bogdan-mitrea/voltage-regulator_p1/Layout/layout.JPG

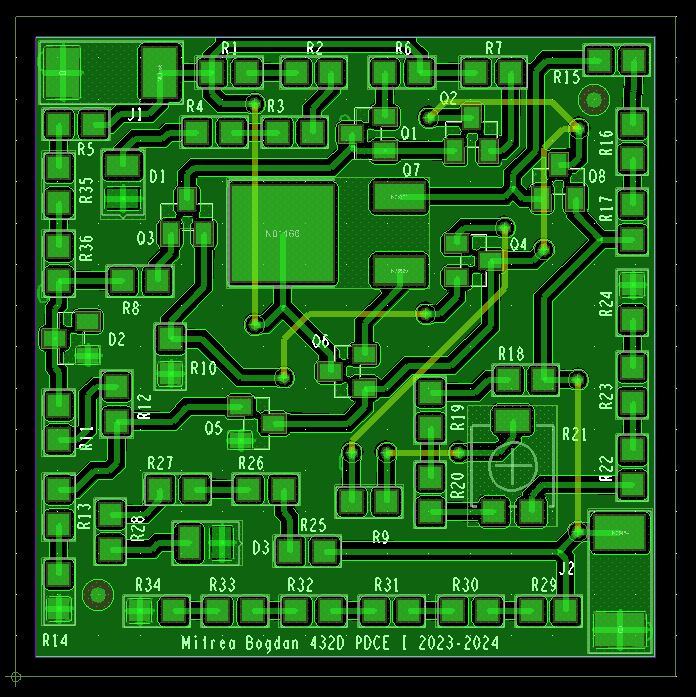
Layout/layout.JPG
