bogdan-mitrea/voltage-regulator_p1/Proiect docs/P1 documentatie.pdf

# Universitatea „POLITEHNICA” Bucuresti

FACULTATEA DE ELECTRONICĂ, TELECOMUNICAȚII ȘI TEHNOLOGIA INFORMAȚIEI

# Proiect 1

# Stabilizator de tensiune cu Element de Reglaj Serie (ERS)

# Mitrea Bogdan-Gabriel

# Grupa 432Da

2023 – 2024

## Tema 3 - Stabilizator de tensiune cu Element de Reglaj Serie (ERS)

### 1. Tema proiectului:

Se proiecteaza si se realizeaza un stabilizator de tensiune cu ERS avand urmatoarele caracteristici:

¨ Tensiunea de ieșire reglabilă în intervalul: 9,5 ÷ 19 [V];

¨ Element de reglaj serie;

¨ Sarcina la ieșire: 760 [Ω];

¨ Deriva termică < 2mV/oC;

¨ Protecție la suprasarcină prin limitarea temperaturii tranzistorului regulator serie la 120oC, si a curentului maxim la 0,5A;

¨ Tensiune de intrare în intervalul: 34,2 ÷ 38 [V];

¨ Amplificarea în tensiune minimă (în buclă deschisă) a amplificatorului de eroare: minim 100;

¨ Domeniul temperaturilor de funcționare: 0o

-60o C (verificabil prin testare în temperatură);

¨ Semnalizarea prezenței tensiunilor de intrare/ieșire cu diodă de tip LED.

### 2. Schema bloc functionala:

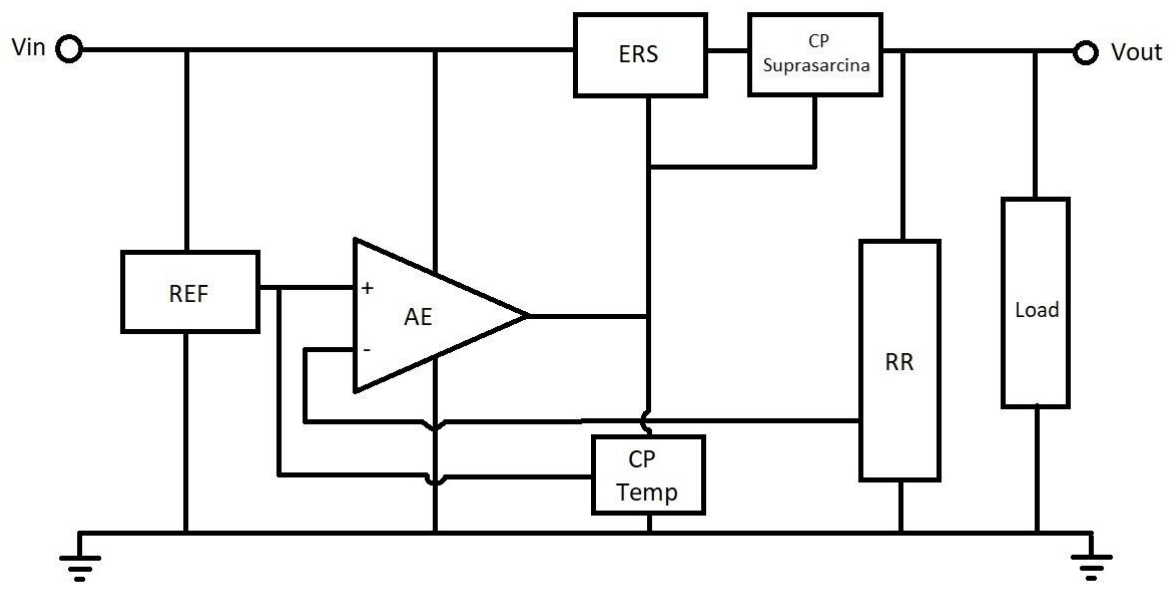
[picture p8: figure]

Se folosește un sistem de stabilizare cu un element regulator în serie (ERS) controlat de un amplificator de eroare (AE), care compară tensiunea furnizată de referință (REF) cu tensiunea preluată de la ieșire prin intermediul rețelei de reacție (RR). De asemenea, este implementat un circuit de protecție împotriva suprasarcinii, si împotriva temperaturii.

### 3. Schema electrica detaliata:

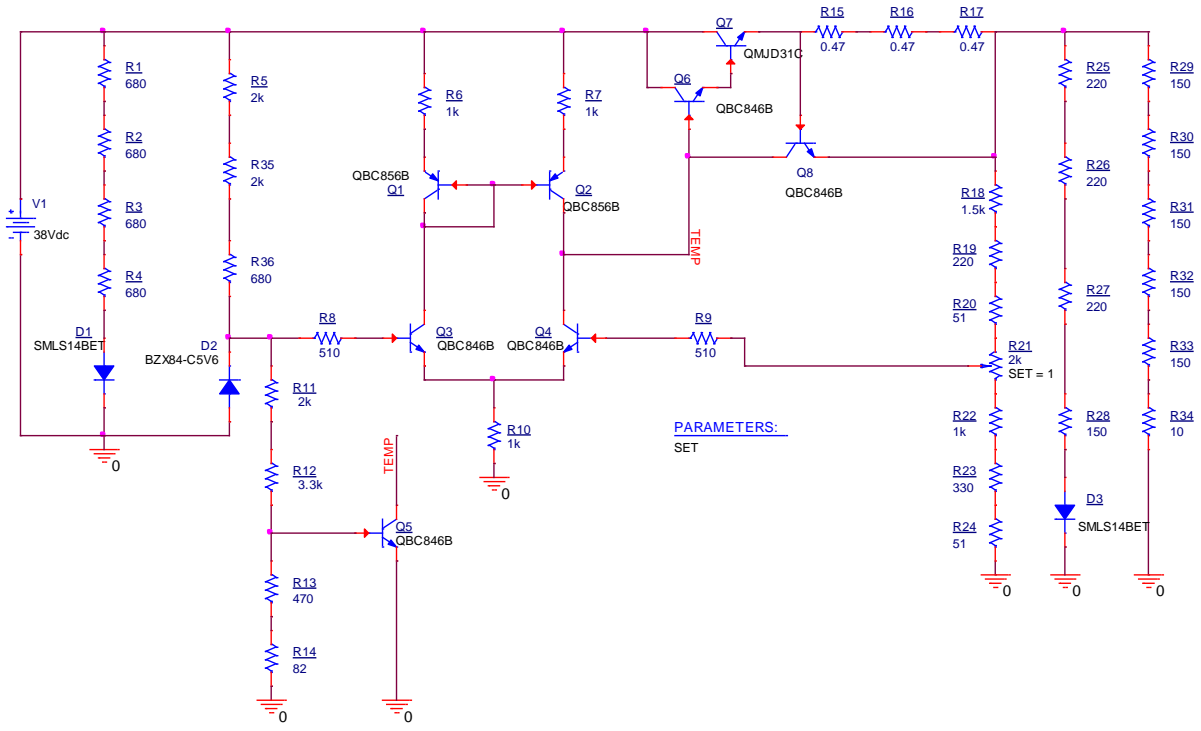
[picture p9: figure]
QBC846B; PARAMETERS:; SET; SMLS14BET; R21 2k SET = 1; Q3 QBC846B; 38Vdc; QMJD31C; Q5 QBC846B; Q4 QBC846B; Q2 QBC856B; QBC856BTEMP; D1 SMLS14BET; TEMP; 510 D2 BZX84-C5V6

Referinta de tensiune: R5, R35, R36, D2; D2 are o tensiune constanta, iar R5, R35 si R36 regleaza curentul care ajunge catre D2 si catre circuitul de protectie la temperatura.

Amplificatorul de eroare: Q1 - Q4, R6 – R10; Oglinda de curent are rolul de a diviza curentul in 2 curenti egali, iar rezistenta R10 pentru a putea cadea pe acea rezistenta o tensiune. R8 si R9 ajuta la amplificare – cu ajutorul lor am putut seta o amplificare dorita (3000).

Circuitul de protectie la temperatura: Q5, R11 – R14; Alegerea raportului de rezistente este important pentru a seta VBE la o valoare sub 0.7V (in acest caz 0.53V), din care se poate afla Ic al tranzistorului, care va trebui sa se deschida, sa curga curent prin el la o temperatura de 120⁰C.

Circuitul de protectie la suprasarcina: Q8, R15 – R17; Trebuie aleasa o rezistenta cat mai mica, deoarece la scurtcircuit la iesire, toata tensiunea va cadea pe rezistenta mica => curent mare, dimensionat la aproximativ 0.5A.

Elementul de reglaj serie: Q6, Q7; Stabilizeaza tensiunea de iesire.

Reteaua de reactie negativa: R18 – R24; Pentru a regla tensiunea minima, respectiv maxima la iesire, prin prezenta unui potentiometru.

Load: R29 – R34; Pentru stabilitate, si pentru a regla cantitatea de curent care trece prin circuit.

Relatii de dimensionare:

Vout / Vref = 1 + (R18 + R19 + R20 + SET*R21) / ((1-SET)*R21 + R22 + R23 + R24);

Vref reprezinta tensiunea de la intrarea amplificatorului de eroare.

De asemenea, un rol important la protectia asupra sarcinii si a temperaturii o au dimensionarea divizorului de
tensiune R11-12 | R13-14 si alegerea rezistentei foarte mici.

In circuit exista si doua ramuri pe care apar doua LED-uri, pentru a semnaliza tensiunea de intrare, respectiv iesire. Alegerea rezistentelor conectate in serie cu cele doua LED-uri depind de reglarea intensitatii care trece prin LED: ILED intre [10,20] mA.

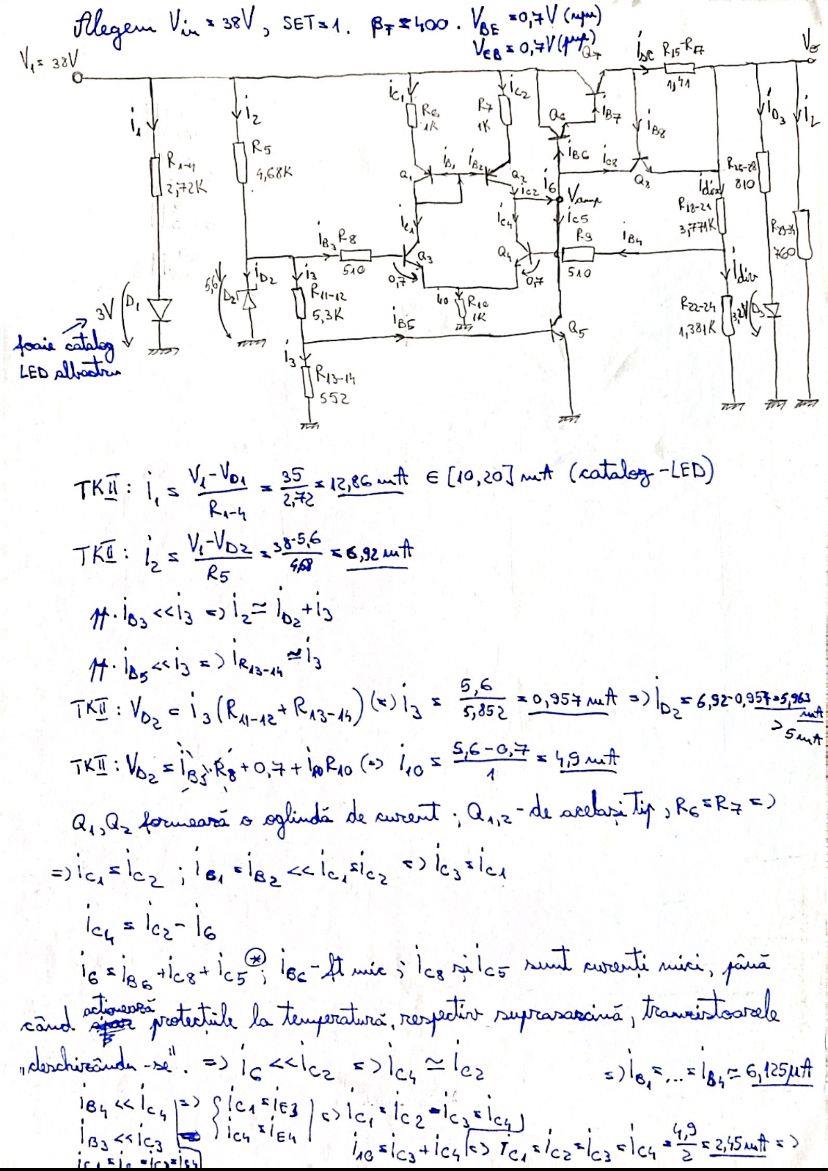
[picture p10: page 5]

Punctul static de functionare(PSF) calculat (pentru SET = 1):

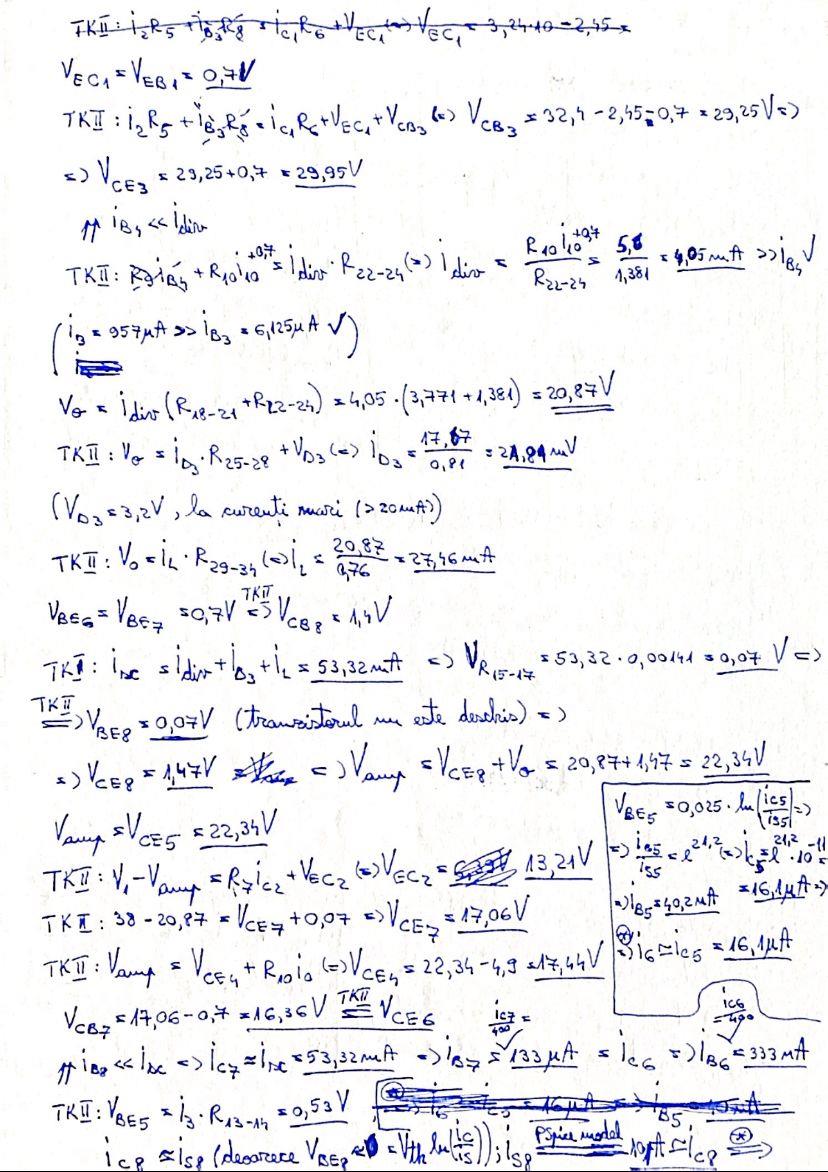
[picture p11: page 6]
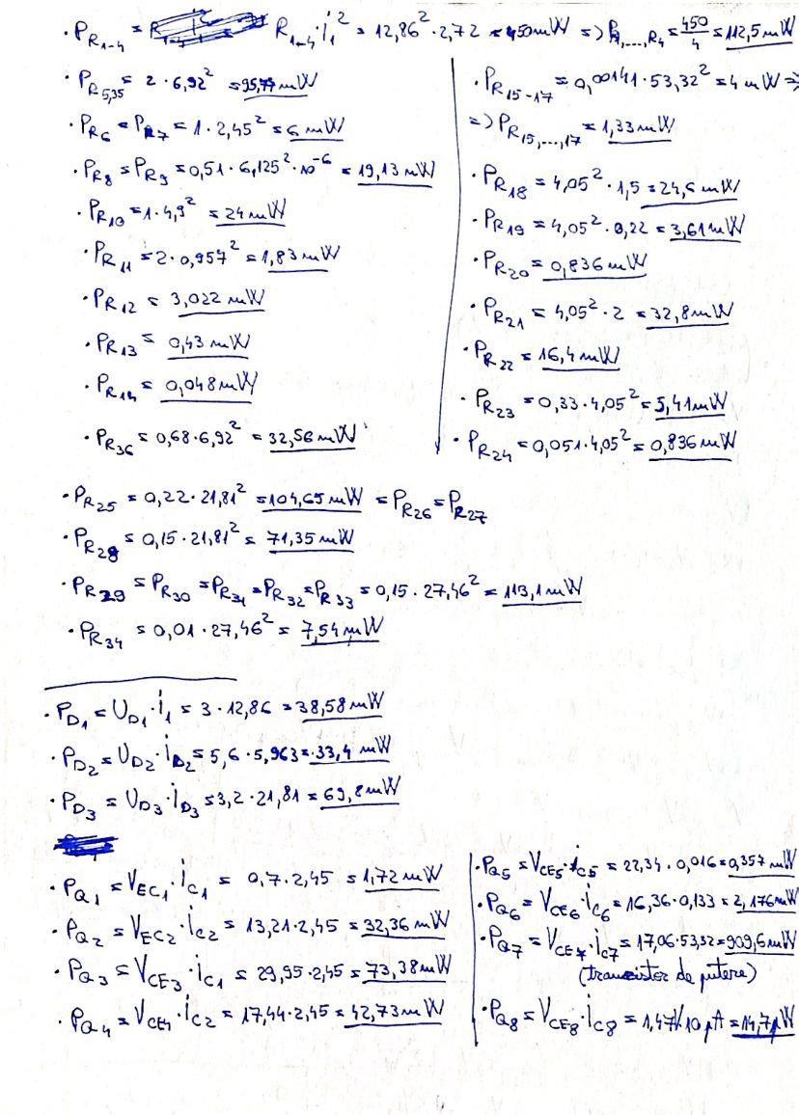
[picture p12: page 7]
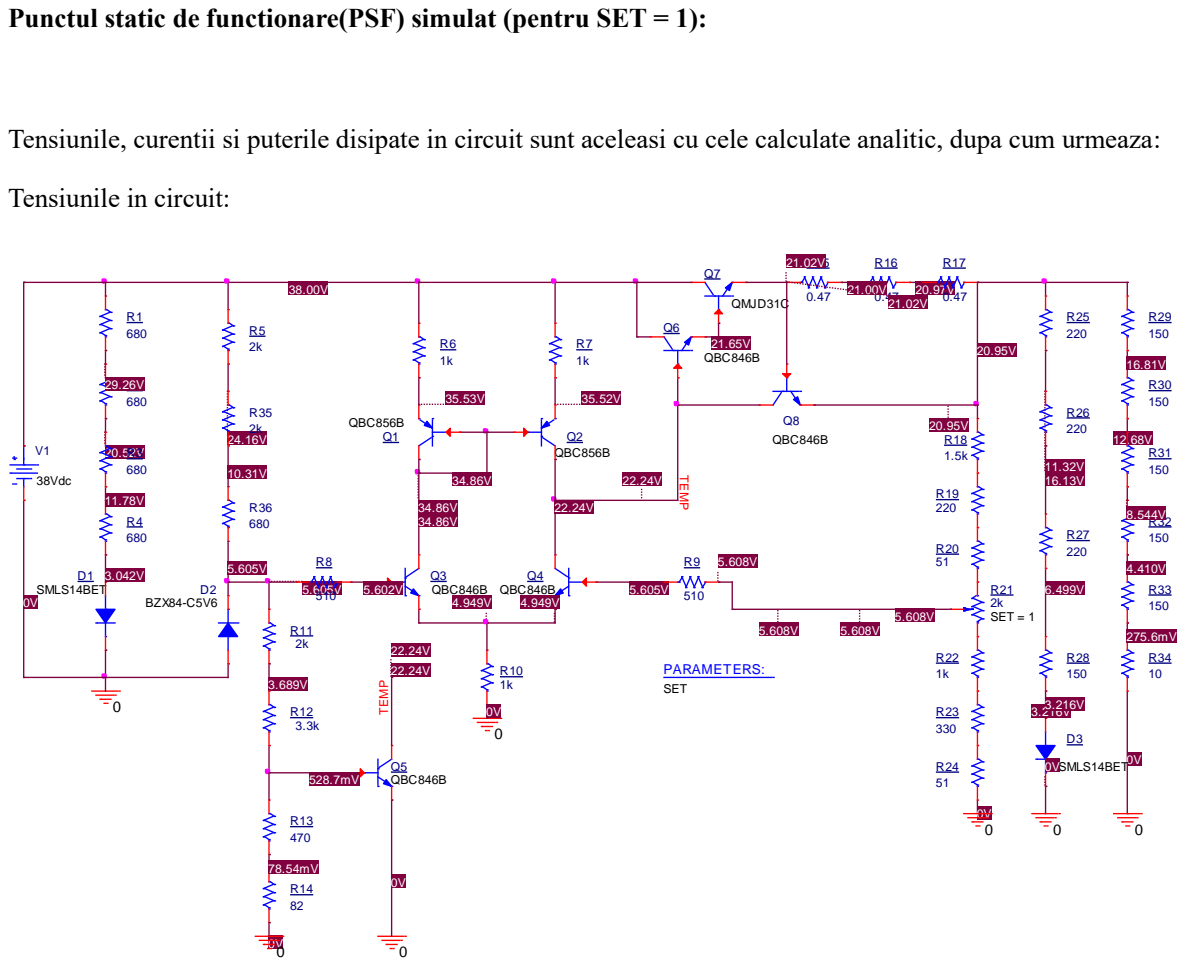
[picture p13: page 8]

Punctul static de functionare(PSF) simulat (pentru SET = 1):

Tensiunile, curentii si puterile disipate in circuit sunt aceleasi cu cele calculate analitic, dupa cum urmeaza:

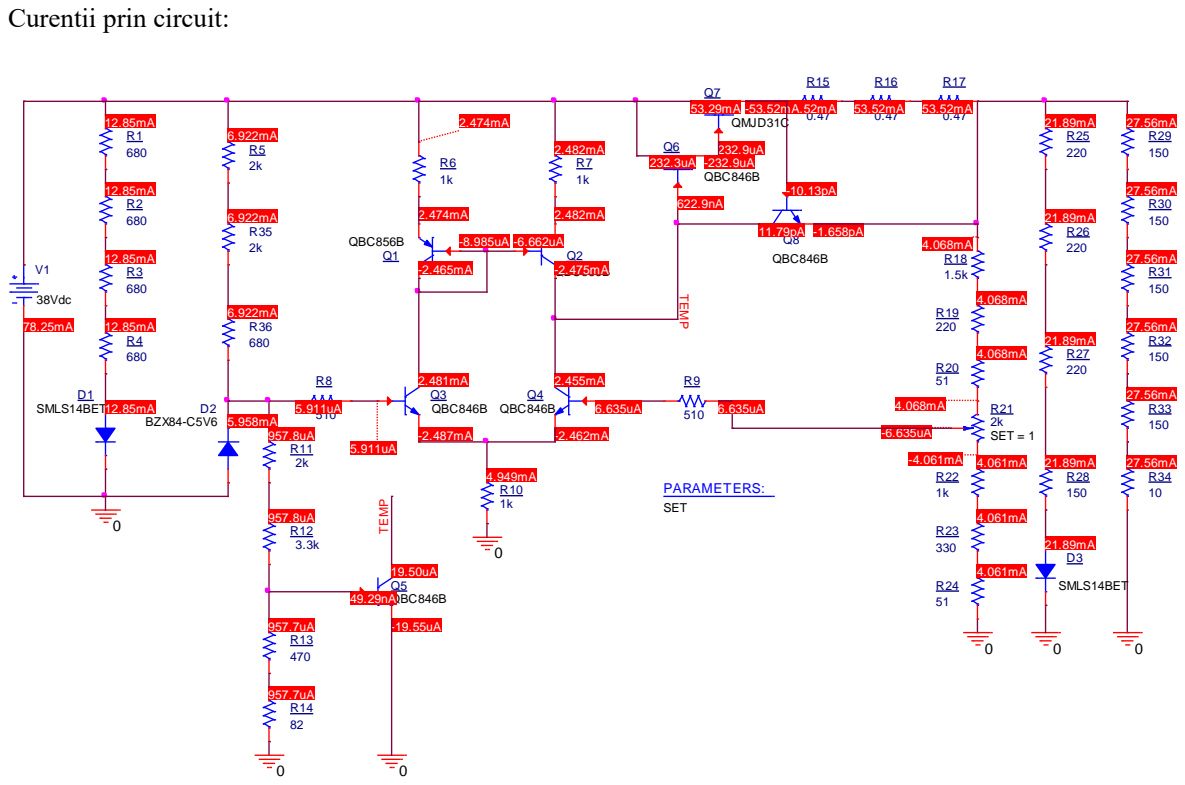
[picture p14: page 9]

# QBC856B 1.640mW TEMP

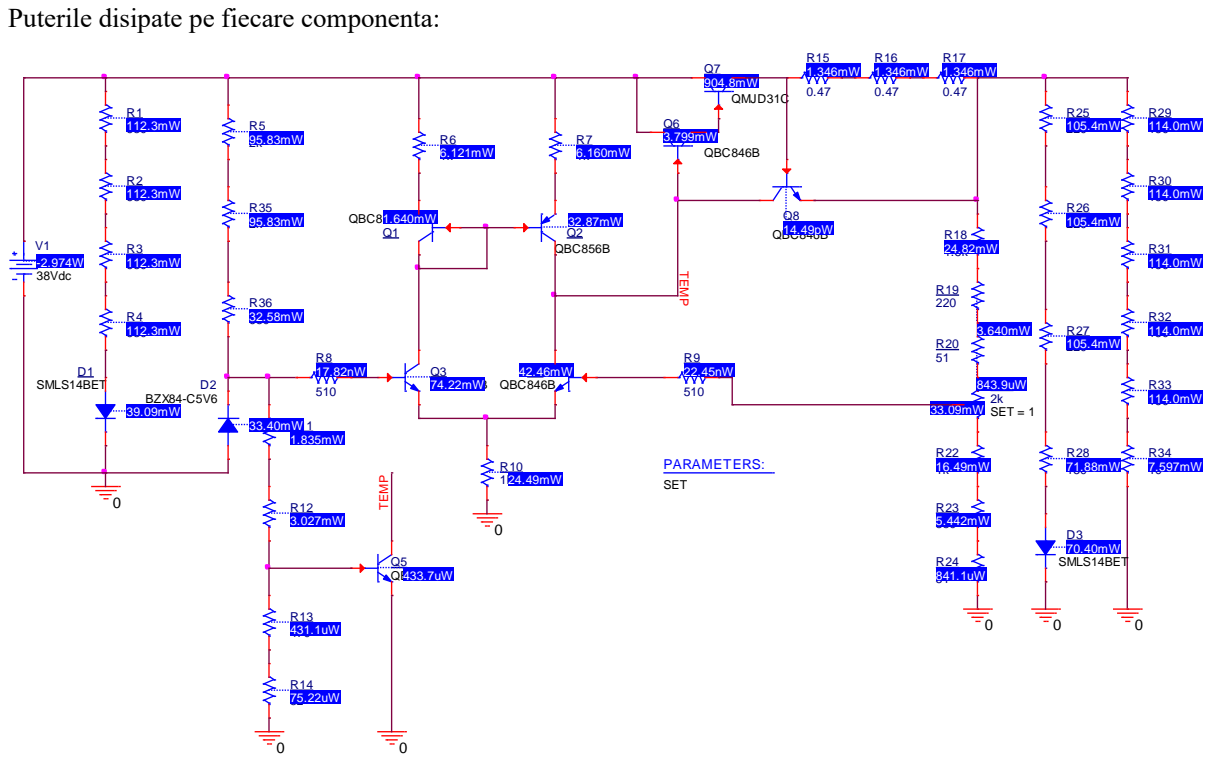
[picture p15: page 10]

Puterile disipate pe fiecare componenta:

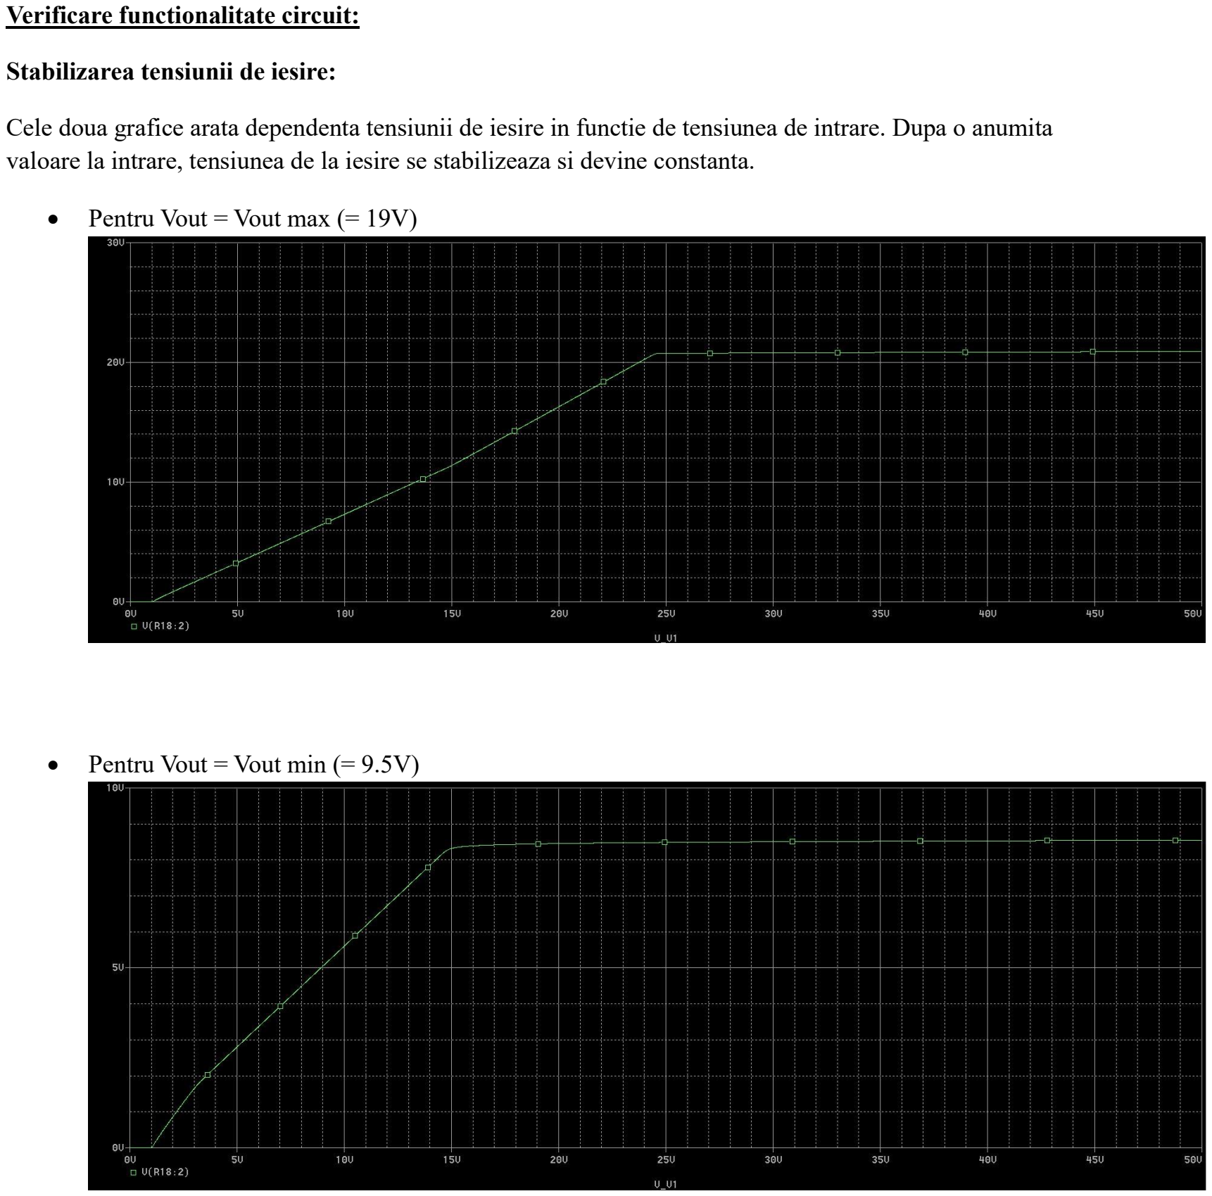
[picture p16: page 11]

Verificare functionalitate circuit:

Stabilizarea tensiunii de iesire:

Cele doua grafice arata dependenta tensiunii de iesire in functie de tensiunea de intrare. Dupa o anumita valoare la intrare, tensiunea de la iesire se stabilizeaza si devine constanta.

- Pentru Vout = Vout max (= 19V)
- Pentru Vout = Vout min (= 9.5V)

Variatia tensiunii de iesire in functie de potentiometru:

Acest grafic reprezinta variatia tensiunii de la iesire in functie de SET-ul potentiometrului de la reteaua de reactie negtiva, ce ia valori intre 0 si 1. Dupa cum se cere, Vout trebuie sa fie in intervalul {9.5, 19} V, valori pe care le-am micsorat, resprectiv majorat cu 10%, astfel ca noul interval este {8.55, 20.9} V.

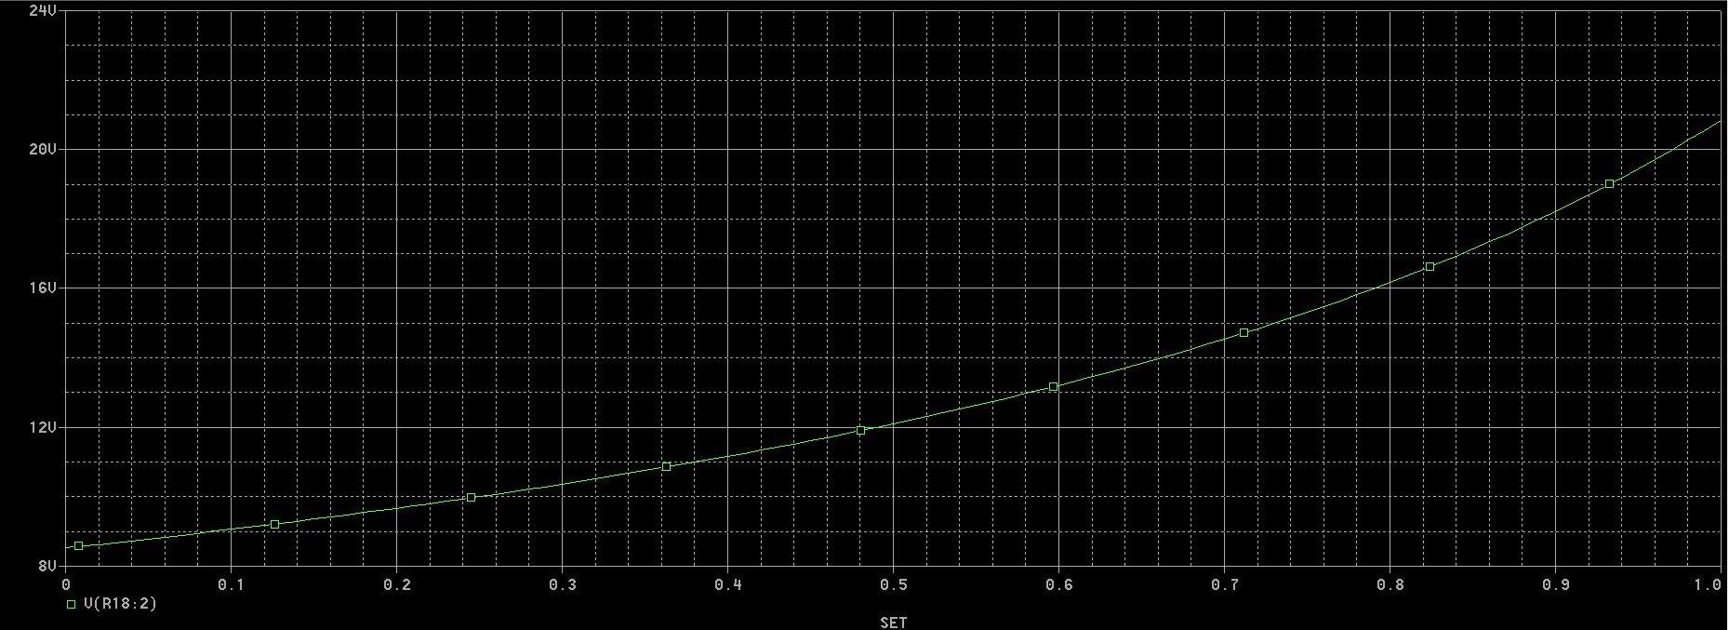
[picture p17: figure]

In continuare, am lucrat cu SET = 1.

# QBC856BTEMP

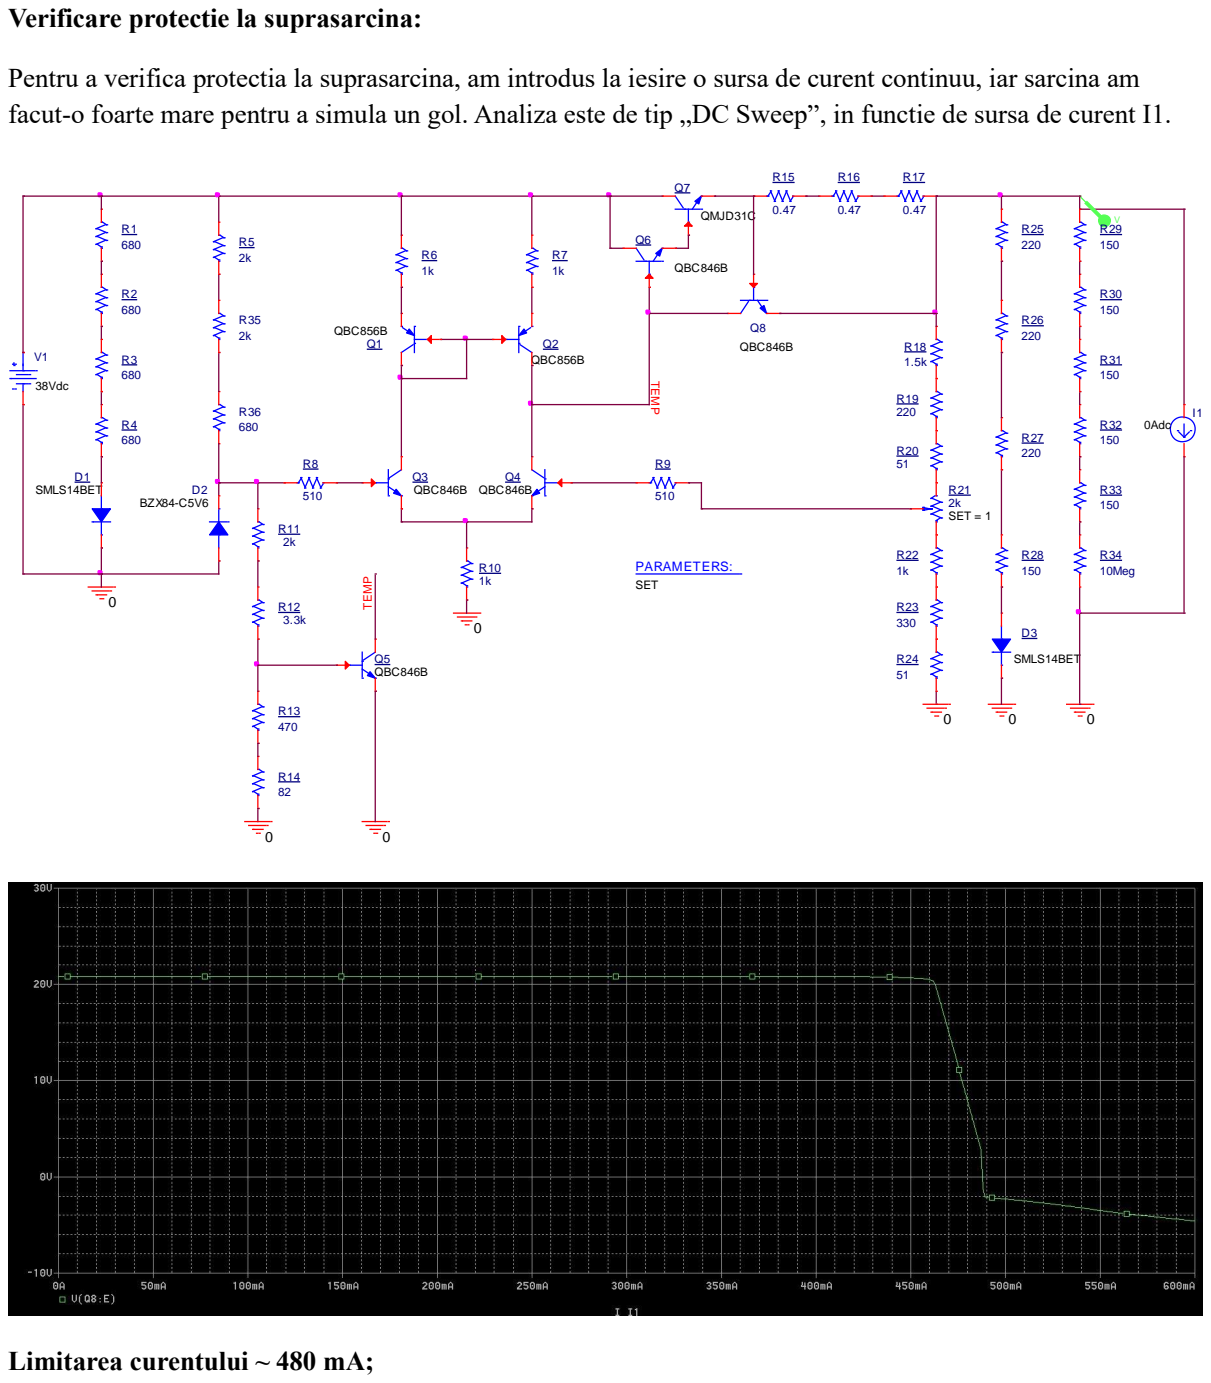
[picture p18: page 13]

Verificare protectie la suprasarcina:

Pentru a verifica protectia la suprasarcina, am introdus la iesire o sursa de curent continuu, iar sarcina am
facut-o foarte mare pentru a simula un gol. Analiza este de tip „DC Sweep”, in functie de sursa de curent I1.

# QBC856BTEMP

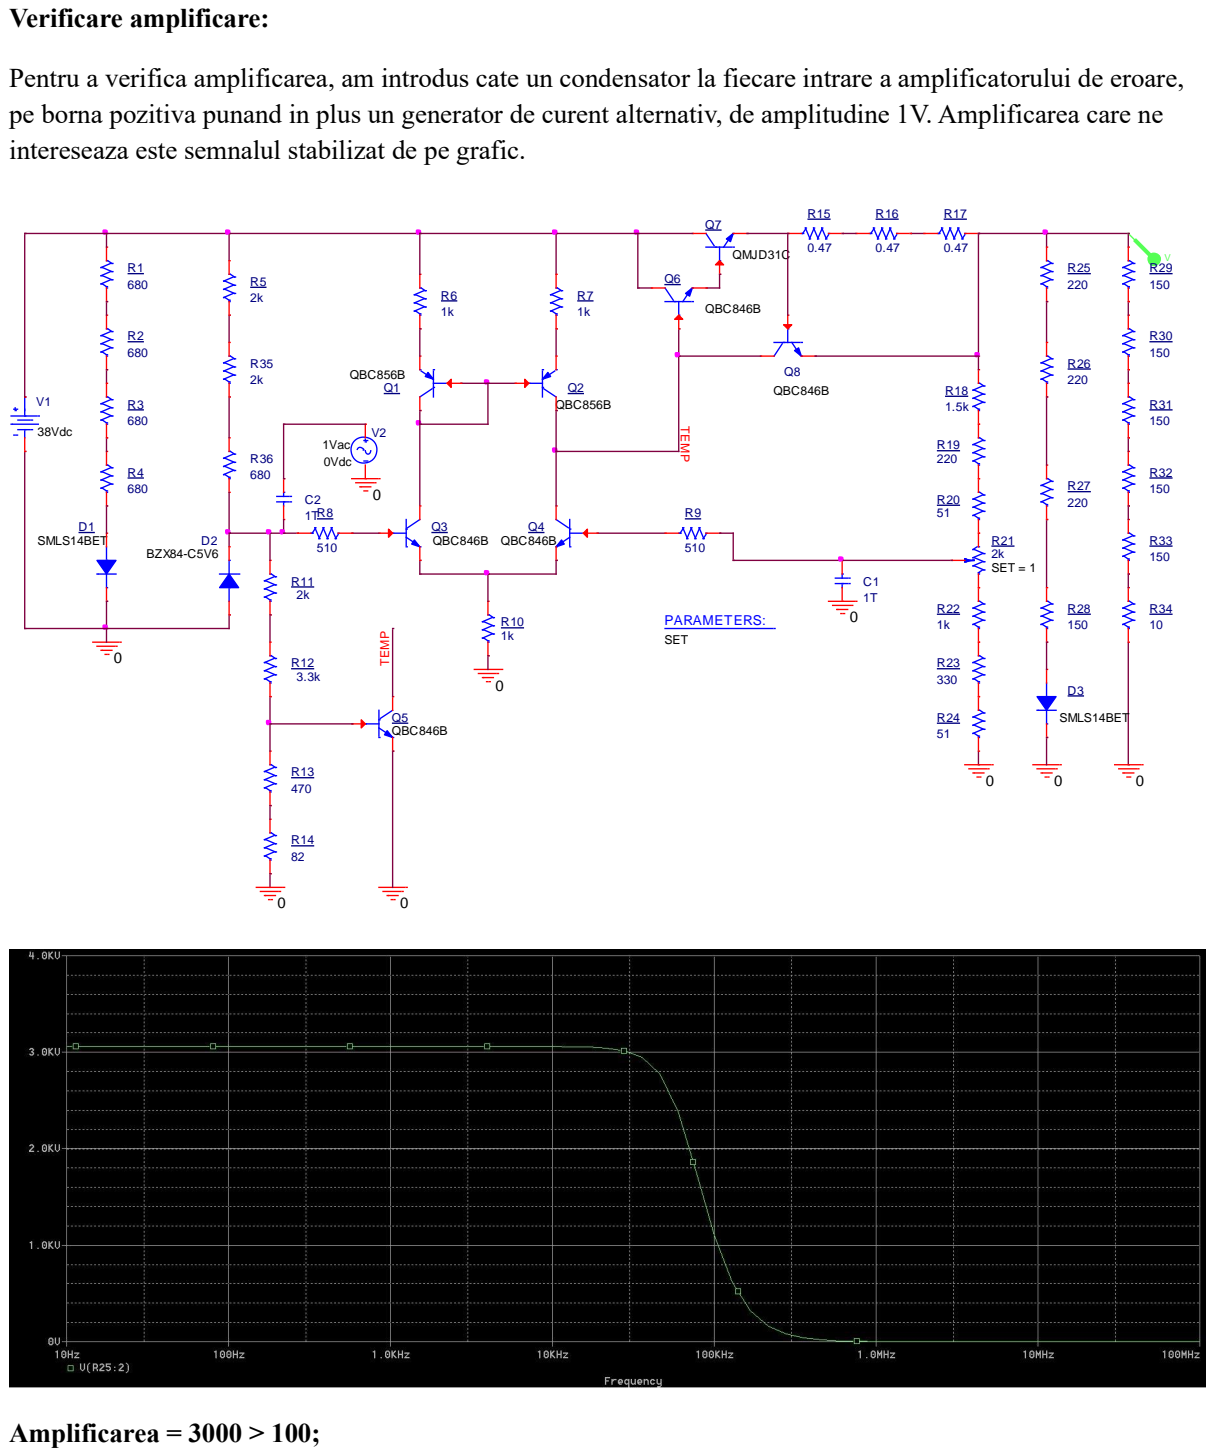
[picture p19: page 14]

Pentru a verifica amplificarea, am introdus cate un condensator la fiecare intrare a amplificatorului de eroare,
pe borna pozitiva punand in plus un generator de curent alternativ, de amplitudine 1V. Amplificarea care ne
intereseaza este semnalul stabilizat de pe grafic.

Verificare protectie la temperatura + deriva termica:

Pe grafic se poate observa faptul ca semnalul de la iesire este stabil pana la temperatura de 120⁰C, dupa care scade brusc pana la 0V.

Incercuit in coltul din dreapta jos este folosirea cursorilor si calculul pantei, ceea ce determina deriva termica. Am luat cursorii convenabil, astfe incat Y2-Y1 = 1, iar deriva termica este X2-X1.

Deriva termica = 1.59 < 2 mV / 0C;

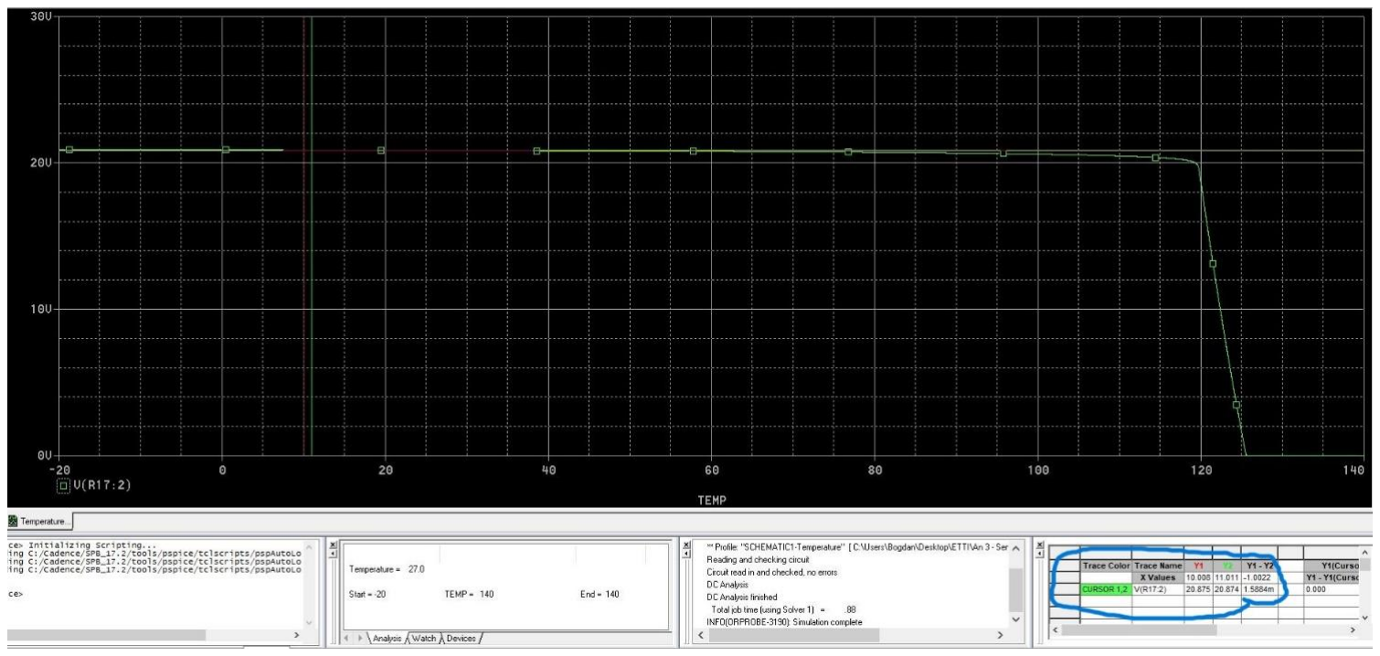
[picture p20: figure]

### ETAPA 2 – PCB:

Layoutul realizat in aplicatia „OrCAD PCB Editor”:

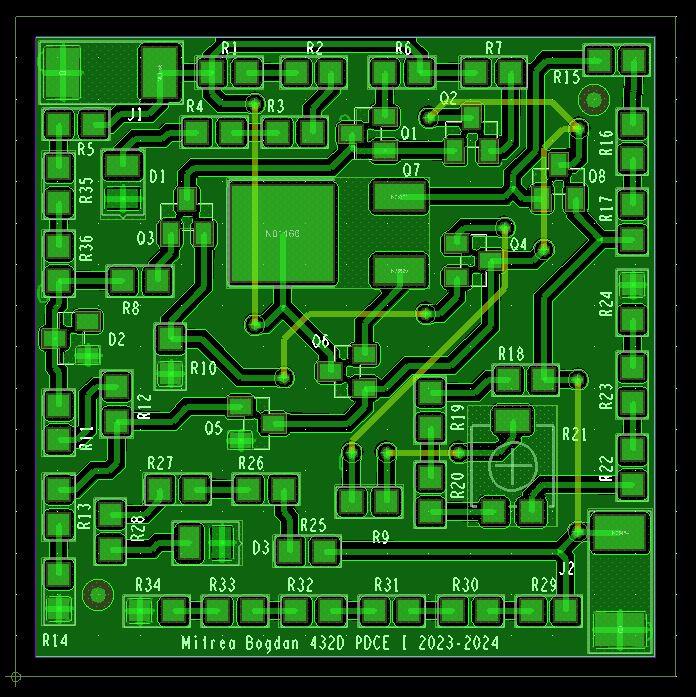
[picture p21: figure]

Footprinturile folosite pentru componente:

- Rezistoare R1...R36 (fara R21) – SMR0805;
- Potentiometru R21 – TS53YL;
- LED-uri D1, D3 – SMD0805;
- Dioda Zener D2 – TO236AA;
- Tranzistoare NPN/PNP Q1...Q8 (fara Q7) – TO236AA;
- Tranzistor de putere Q7 – DPACK;
- Conectori J1, J2 – SMR2512;

### Fisiere Gerber:

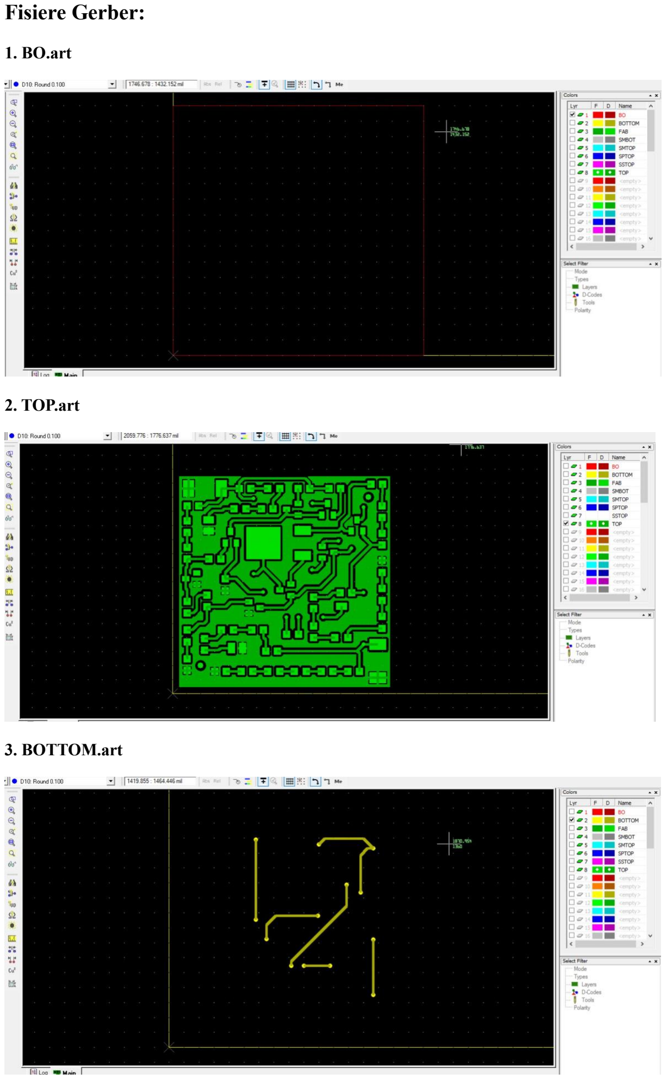
[picture p22: page 17]

### 1. BO.art

### 2. TOP.art

### 3. BOTTOM.art

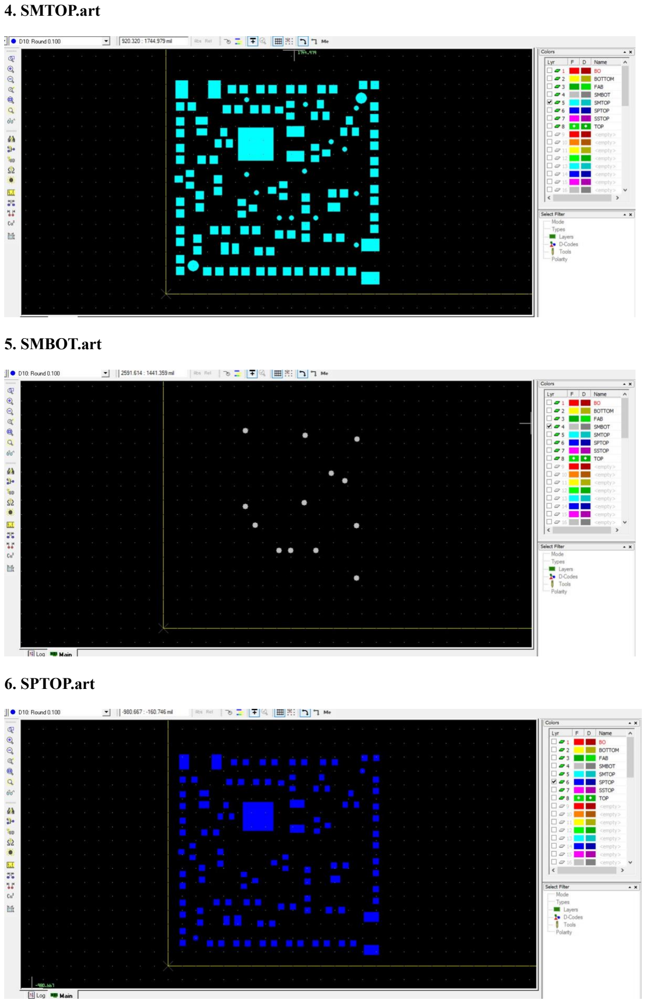
[picture p23: page 18]

### 4. SMTOP.art

### 5. SMBOT.art

### 6. SPTOP.art

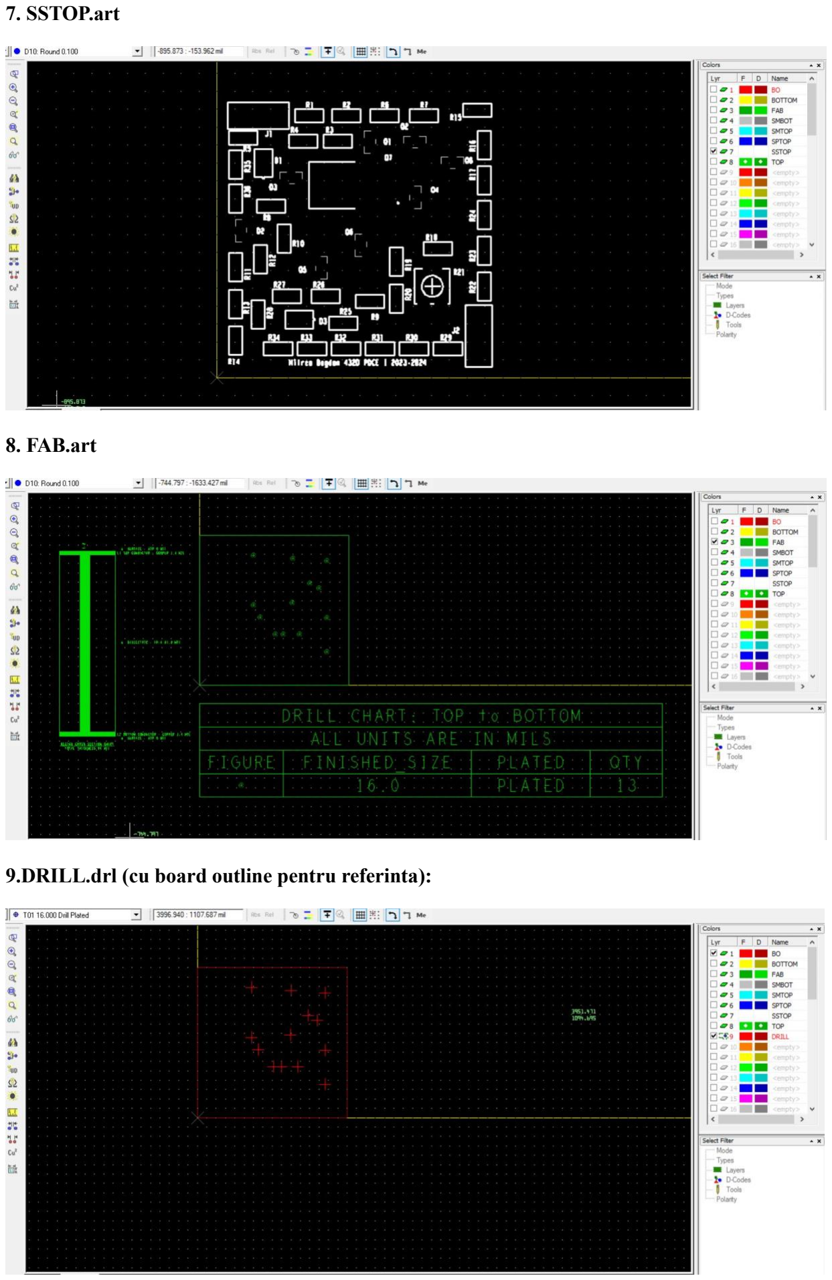
[picture p24: page 19]

### 7. SSTOP.art

### 8. FAB.art

9.DRILL.drl (cu board outline pentru referinta):
