bogdan-mitrea/voltage-regulator_p1/Proiect docs/PSF.pdf

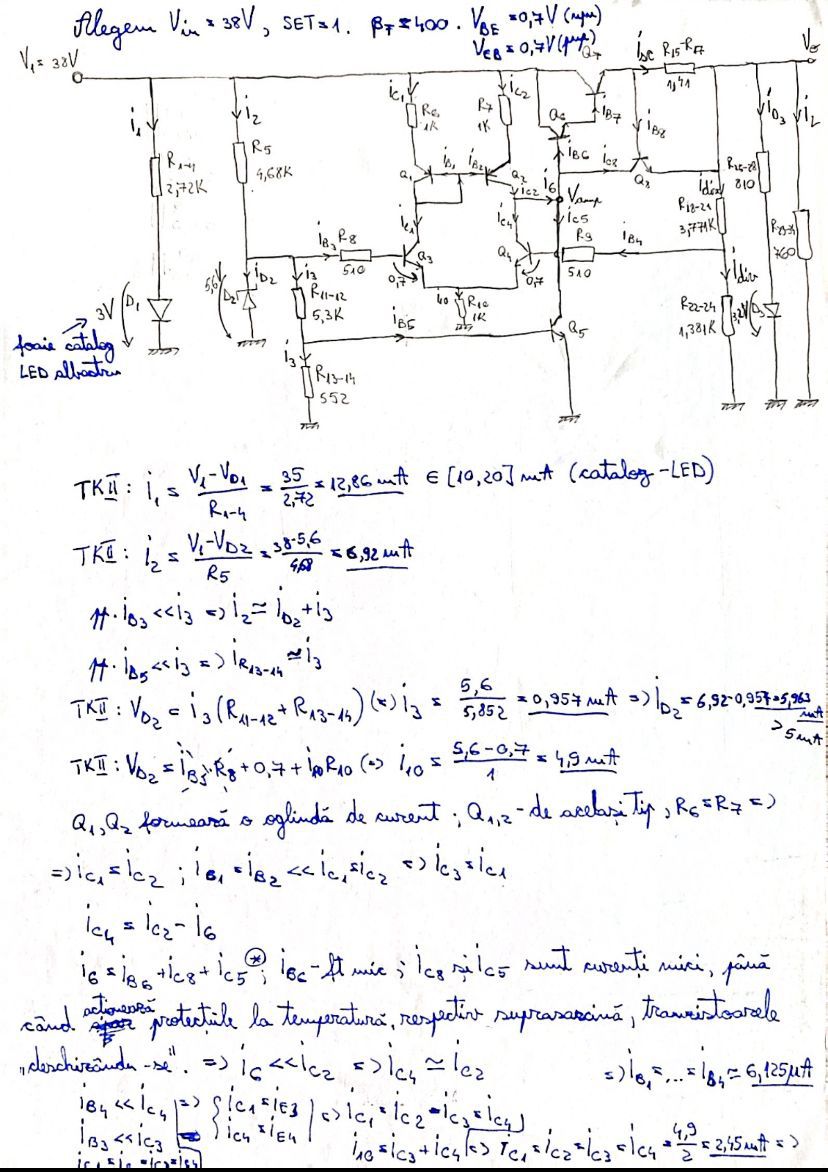
[picture p25: page 1]
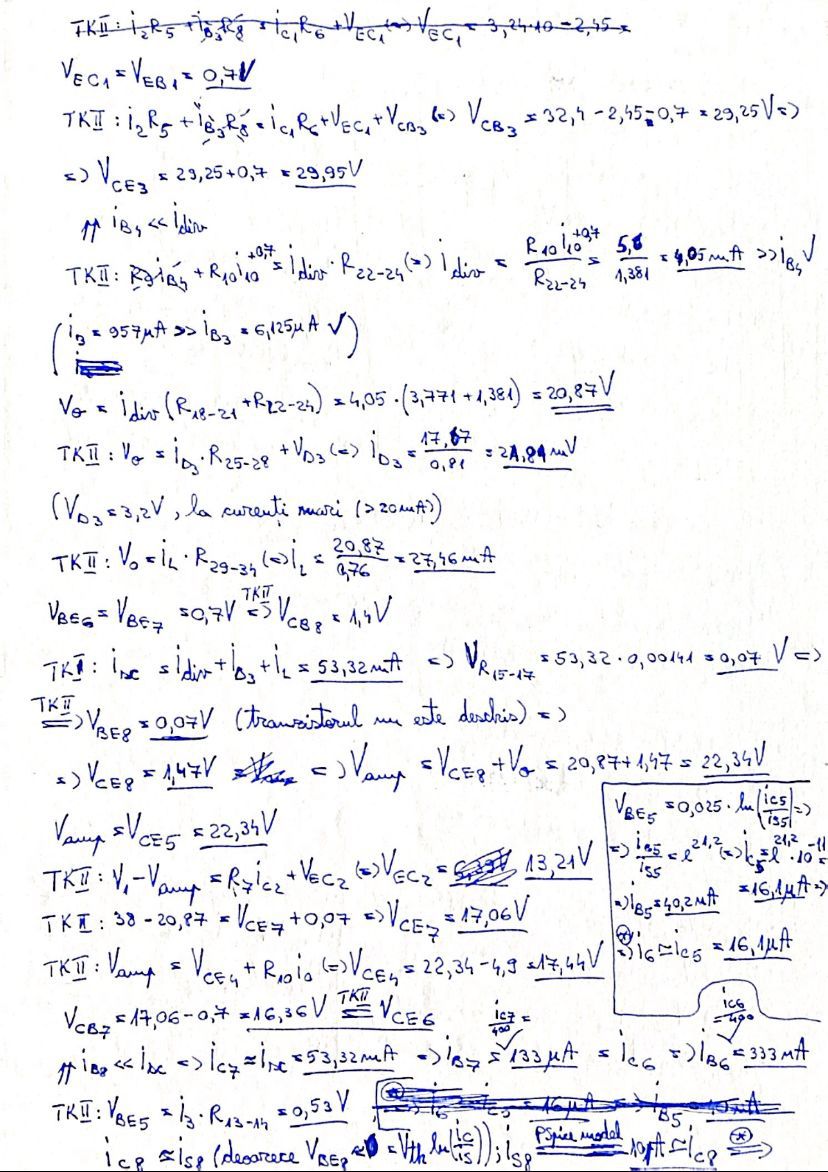
[picture p26: page 2]
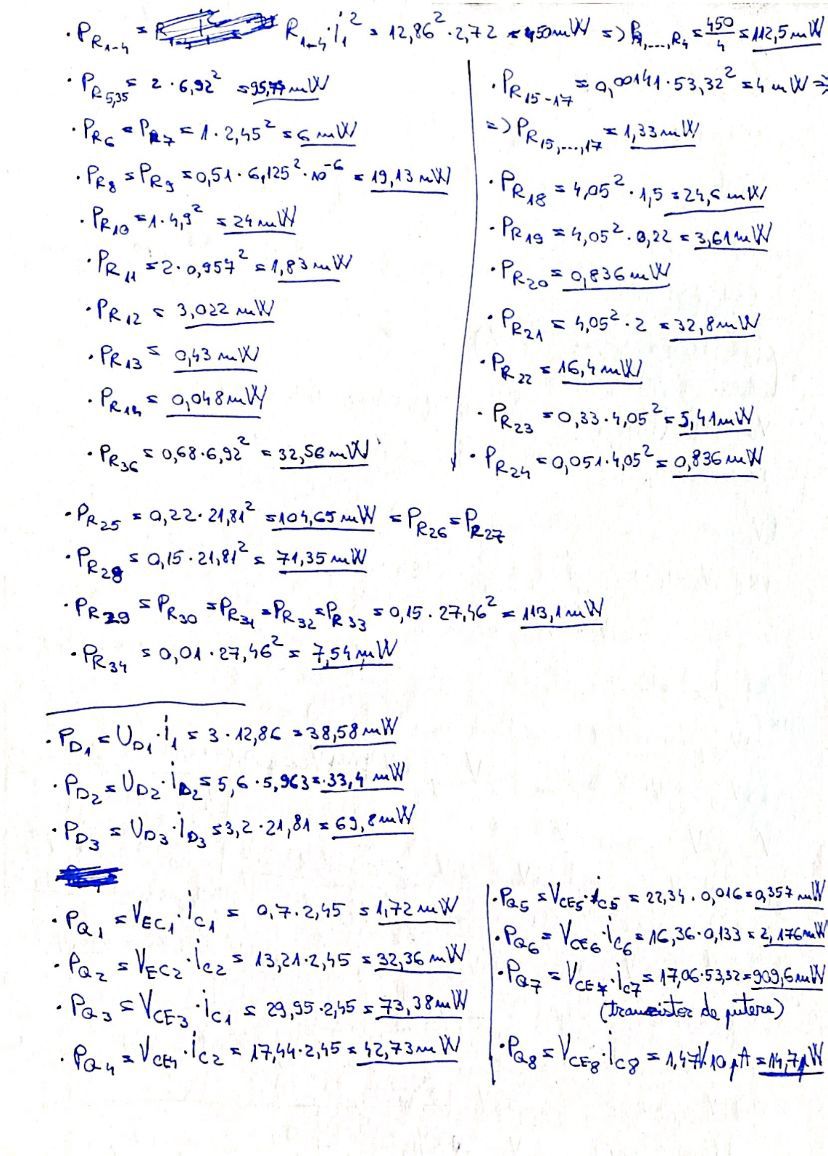
[picture p27: page 3]
