bogdan-mitrea/voltage-regulator_p1/Simulations/amplificare.JPG

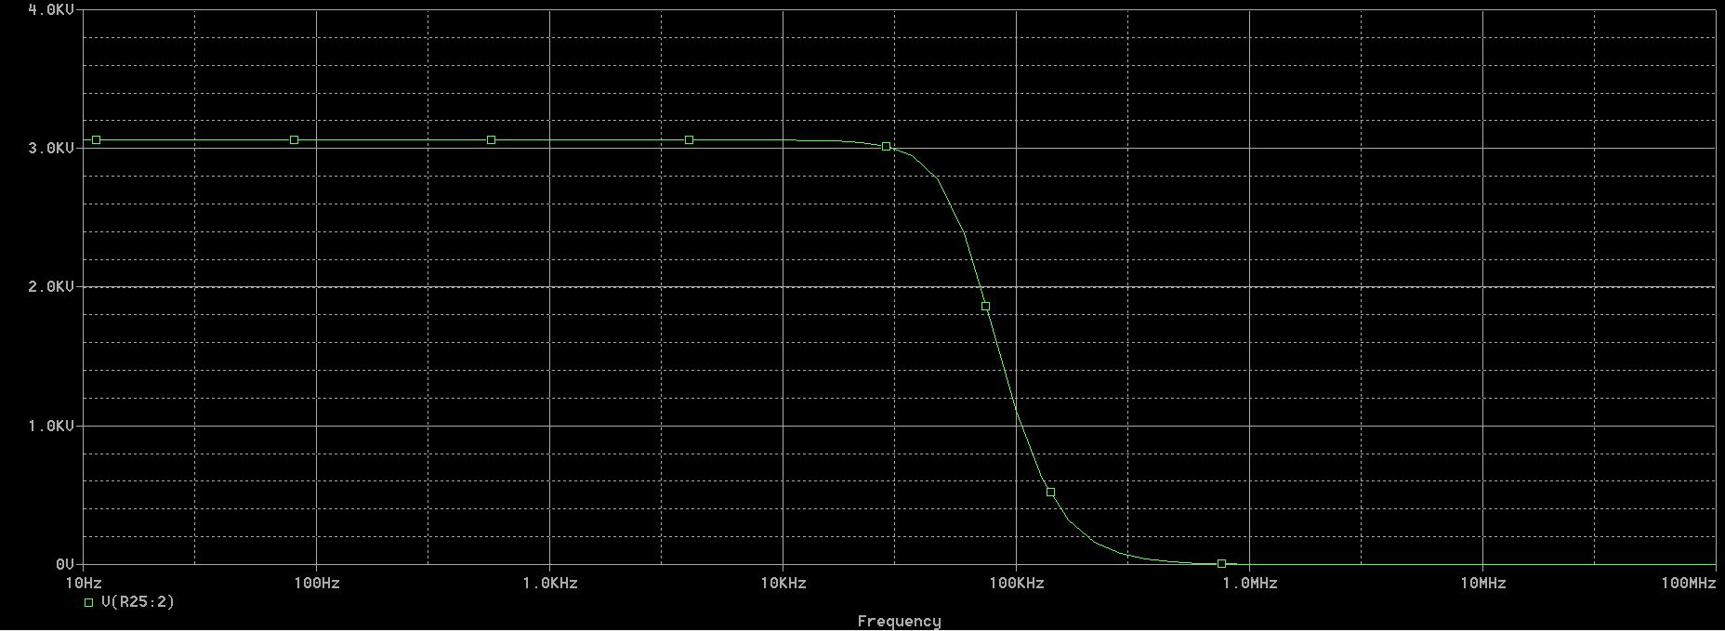
Simulations/amplificare.JPG
