bogdan-mitrea/voltage-regulator_p1/Simulations/suprasarcina.JPG

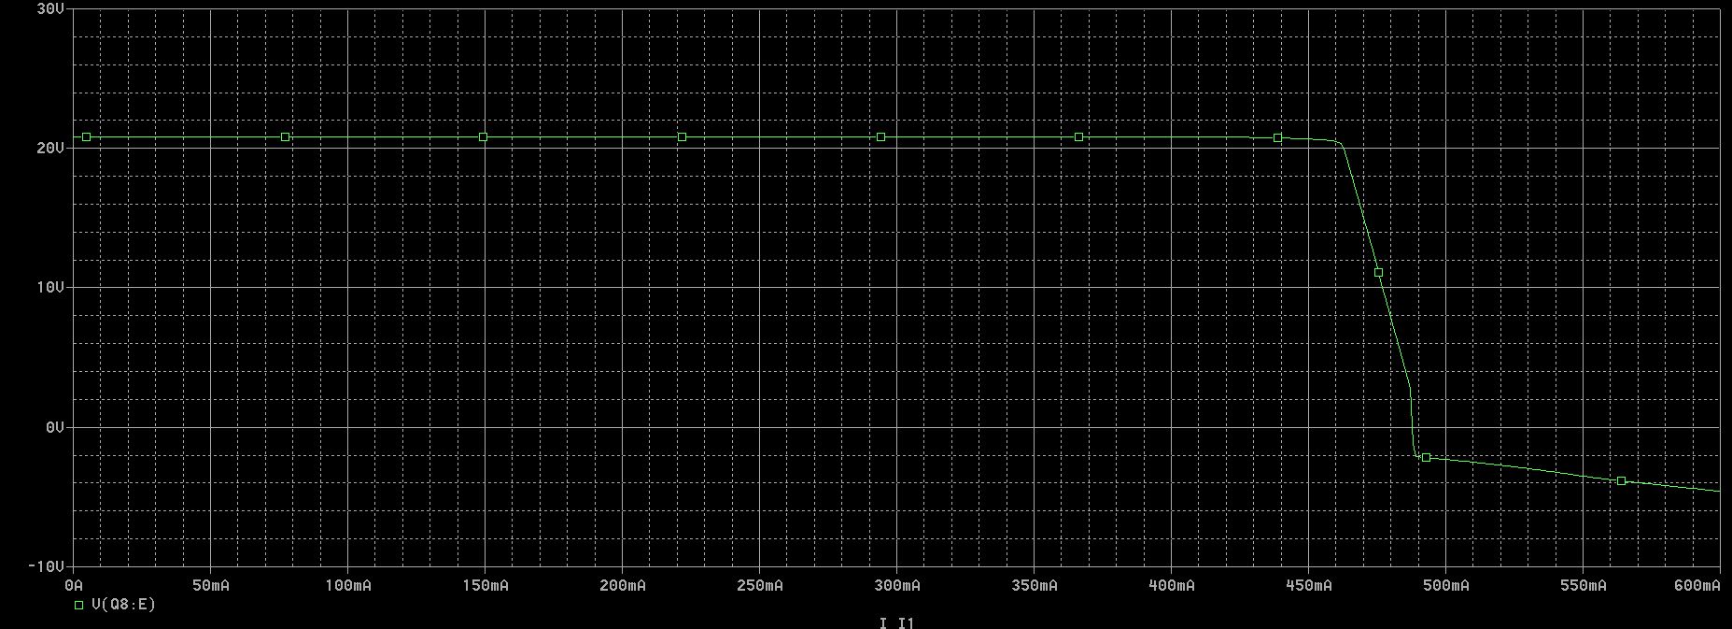
Simulations/suprasarcina.JPG
