bogdan-mitrea/voltage-regulator_p1/Simulations/Temperatura + deriva termica.JPG

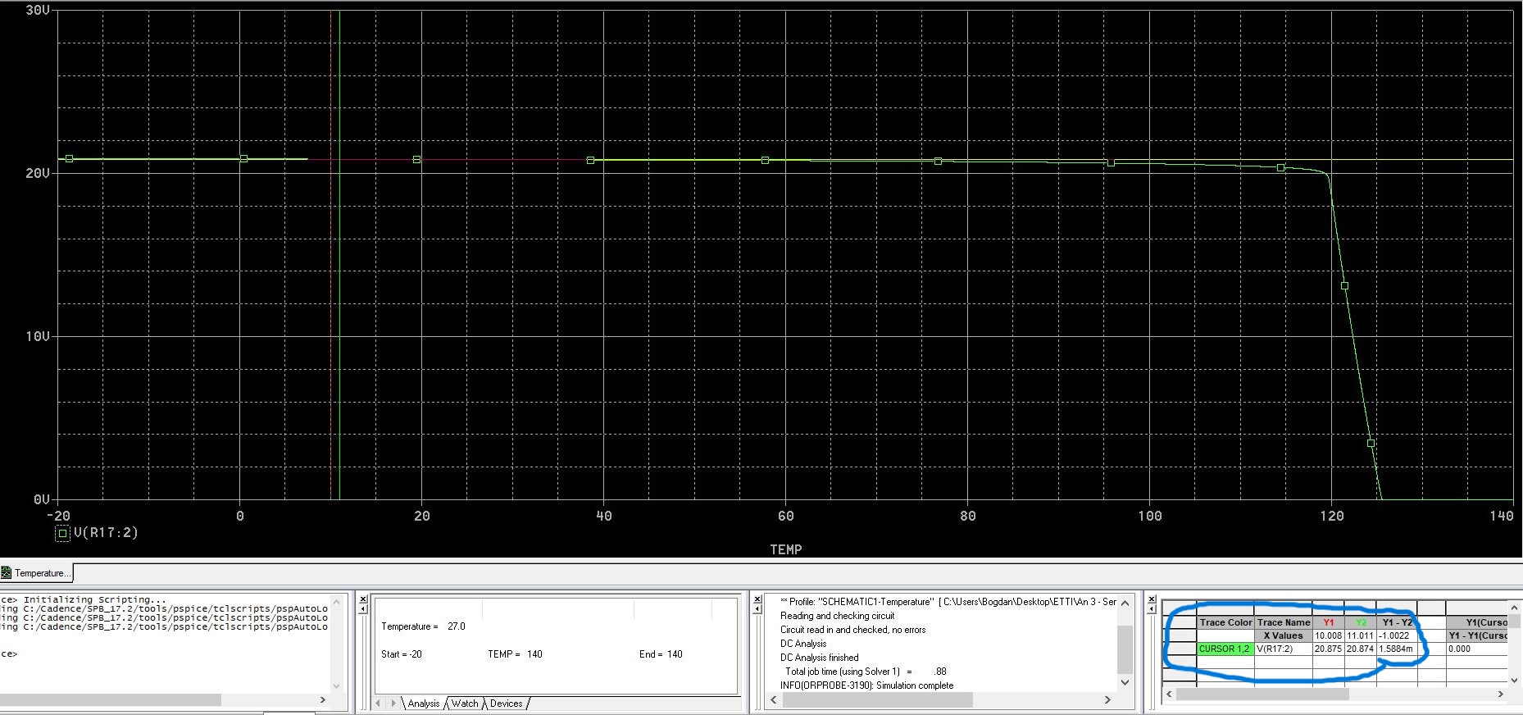
Simulations/Temperatura + deriva termica.JPG
