bogdan-mitrea/voltage-regulator_p1/Simulations/Vout(potentiometru).JPG

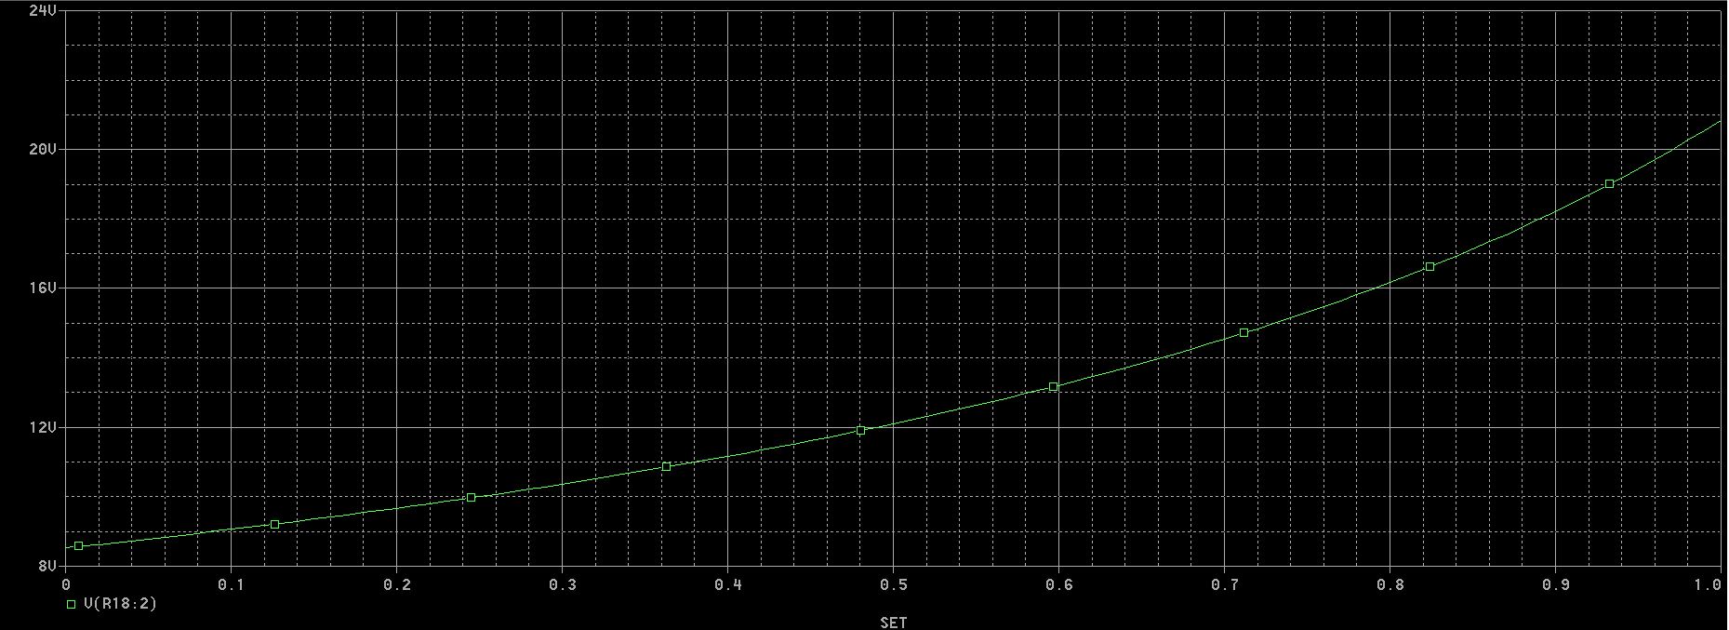
Simulations/Vout(potentiometru).JPG
