bogdan-mitrea/voltage-regulator_p1/(list of files, drawings)

Other design files:
Schematics/Proiect P1 - OrCAD + PCB (etapa 2)/P1 BUN.DSN
Schematics/Proiect P1 - OrCAD + PCB (etapa 2)/P1 bun.opj
