bogdan-mitrea/voltage-regulator_p1/Schematics/Proiect P1 - OrCAD + PCB (etapa 2)/allegro/xsectionChartParams.txt

CHART_UNIT Mils
LAYER_NAME YES
LAYER_THICKNESS YES
LAYER_THICKNESS_TOL NO
MATERIAL_NAME YES
EMB_STATUS NO
ATTACH_METHOD NO
LAYER_TYPE YES
DRILL_SPAN YES
BACKDRILL_SPAN NO
STACKED_VIAS YES
EMD_COMP_LEGEND  NO
DRILL_LABEL  YES
X_SCALE_FACTOR  1.000
DIELECTRIC_SCALE_FACTOR  1.000
TEXT_BLOCK  1
MAX_CHART_HEIGHT 2000 MIL
